sisinn/raspi_telexistence_vr/README.md

# raspi_telexistence_vr  

Display the remote image of Dual Fisheye camera on the VR goggles and experience the telexistence.

<https://github.com/sisinn/raspi_telexistence_vr>  

---
## Main Equipment  

* Raspberry Pi  
* Insta360 Air  
* BNO035  
* VR Goggles (P-VRG03BK)  
* LCD Monitor (LS055-CGS-LCD-SET)  

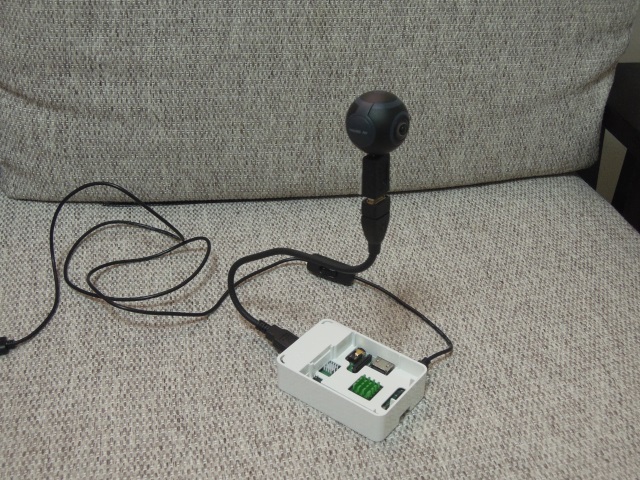
[picture p1: doc/img/sender.jpg]
sender
  
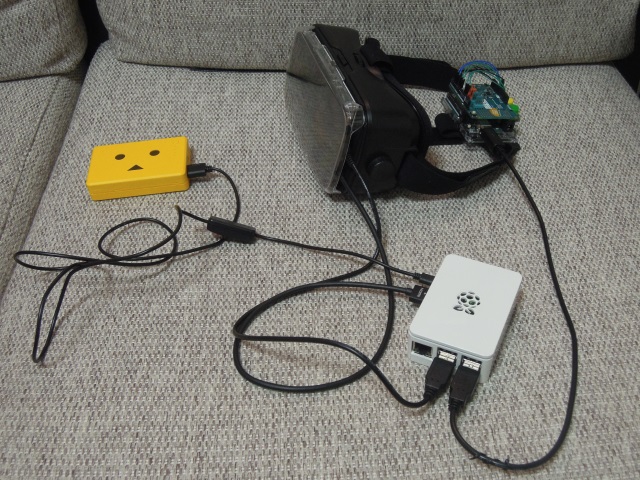
[picture p2: doc/img/receiver.jpg]
receiver
  

---
## Task  

The following sentences are in Japanese only.  
* [Commentary top](https://github.com/sisinn/raspi_telexistence_vr/blob/master/doc/top.md)
* [Raspberry Pi Init](https://github.com/sisinn/raspi_telexistence_vr/blob/master/doc/raspberry_init.md)
* [Sender](https://github.com/sisinn/raspi_telexistence_vr/blob/master/doc/sender.md)  
* [Receiver](https://github.com/sisinn/raspi_telexistence_vr/blob/master/doc/receiver.md)  
* [FFmpeg](https://github.com/sisinn/raspi_telexistence_vr/blob/master/doc/ffmpeg.md)  
* [H264](https://github.com/sisinn/raspi_telexistence_vr/blob/master/doc/h264.md)  
* [openFrameworks](https://github.com/sisinn/raspi_telexistence_vr/blob/master/doc/openframeworks.md)  
* [OpenGL](https://github.com/sisinn/raspi_telexistence_vr/blob/master/doc/vr360.md)  
* [3DoF](https://github.com/sisinn/raspi_telexistence_vr/blob/master/doc/3dof.md)  
* [VR Goggles](https://github.com/sisinn/raspi_telexistence_vr/blob/master/doc/goggles.md)  
* [Complete](https://github.com/sisinn/raspi_telexistence_vr/blob/master/doc/complete.md)  
* [Calibration](https://github.com/sisinn/raspi_telexistence_vr/blob/master/doc/calibration.md)  

---
## Demo  

Virtual Watermelon splitting in side view  
Virtual Watermelon splitting in side view (http://www.youtube.com/watch?v=ms5B0luU0no)  

---
## Author

[sisinn](https://github.com/sisnn)
