sisinn/raspi_telexistence_vr/doc/h264.md

# 全天球カメラとVRゴーグルで、テレイグジスタンス体験(6)

[前ページ](./ffmpeg.md) / [top](./top.md) / [次ページ](./openframeworks.md)  

## 6. H.264対応

MotionJPEGでの配信は、ネットワーク負荷が高いので、H.264で配信ができるように環境を構築する。  

### ■カメラデータの保存
---
FFmpegを使って、UVCのH264データを加工せずに、mp4形式で保存  
```
ffmpeg -f v4l2 -input_format h264 -video_size 1920x960 -framerate 30 -i /dev/video0 -vcodec copy -an test.mp4
```

※時刻情報が認識できないみたい  
```
[mp4 @ 0x2eefda0] Timestamps are unset in a packet for stream 0. This is deprecated and will stop working in the future. Fix your code to set the timestamps properly
[mp4 @ 0x2eefda0] Non-monotonous DTS in output stream 0:0; previous: 0, current: 0; changing to 1. This may result in incorrect timestamps in the output file.
```  

再生確認  
```  
omxplayer --win '0 0 1920 1080' test.mp4
```  

※ちなみに、解像度＝2560x1280では、エンコードはできるが、再生は表示が化けて正しく再生できない。  
もともとハード支援機能の性能的には無理だと思われるので、ここでは深追いしない。  

### ■カメラデータの配信  
---
FFmpegを使って、UVCのH264データを加工せずに、MPEG-TS形式で配信  

送信側  
```
ffmpeg -f v4l2 -input_format h264 -video_size 1920x960 -framerate 30 -i /dev/video0 \
 -vcodec copy -an \
 -f mpegts udp://192.168.11.66:1234
```
※上記では、有線LANで受信側IPアドレスを指定  

受信側  
```  
omxplayer --win '0 0 1920 1080' udp://192.168.11.66:1234
```  

※送信側、受信側どちらを先に起動しても、接続OK  
※UDPで送るため、パケット欠落の可能性がある。その際は、映像が乱れる。  

目視レベルで遅延量が2秒ぐらいある。MotionJPEG時と同等であるが、もう少し改善したい。  

#### 解像度＝1920x960の場合  

＜CPU性能:受信側＞  
```  
Linux 4.14.52-v7+ (raspberrypi)         08/03/18        _armv7l_        (4 CPU)

23:38:50     CPU    %usr   %nice    %sys %iowait    %irq   %soft  %steal  %guest  %gnice   %idle
23:38:50     all    2.66    0.00    3.31    0.63    0.00    0.10    0.00    0.00    0.00   93.30
23:38:50       0    2.30    0.00    3.71    0.54    0.00    0.41    0.00    0.00    0.00   93.04
23:38:50       1    3.42    0.00    3.04    0.43    0.00    0.00    0.00    0.00    0.00   93.11
23:38:50       2    2.40    0.00    3.00    0.64    0.00    0.00    0.00    0.00    0.00   93.95
23:38:50       3    2.50    0.00    3.49    0.89    0.00    0.00    0.00    0.00    0.00   93.12
```  

＜ネットワークトラフィック:受信側＞  
```  
   # Host name (port/service if enabled)            last 2s   last 10s   last 40s cumulative
--------------------------------------------------------------------------------------------
   1 192.168.11.66                            =>         0b         0b         0b         0B
     raspberrypi                              <=     8.45Mb     7.41Mb     7.41Mb     7.41MB
   2 192.168.11.66                            =>     12.6Kb     6.95Kb     6.95Kb     6.95KB
     DESKTOP-SISINN                           <=       960b       440b       440b       440B
   3 192.168.11.66                            =>         0b       288b       288b       288B
     router.asus.com                          <=         0b       425b       425b       425B
--------------------------------------------------------------------------------------------
Total send rate:                                     12.6Kb     7.23Kb     7.23Kb
Total receive rate:                                  8.46Mb     7.41Mb     7.41Mb
Total send and receive rate:                         8.47Mb     7.42Mb     7.42Mb
--------------------------------------------------------------------------------------------
Peak rate (sent/received/total):                     12.6Kb     8.50Mb     8.51Mb
Cumulative (sent/received/total):                    7.23KB     7.41MB     7.42MB
============================================================================================
```  

[前ページ](./ffmpeg.md) / [top](./top.md) / [次ページ](./openframeworks.md)
