sisinn/raspi_telexistence_vr/doc/vr360.pdf

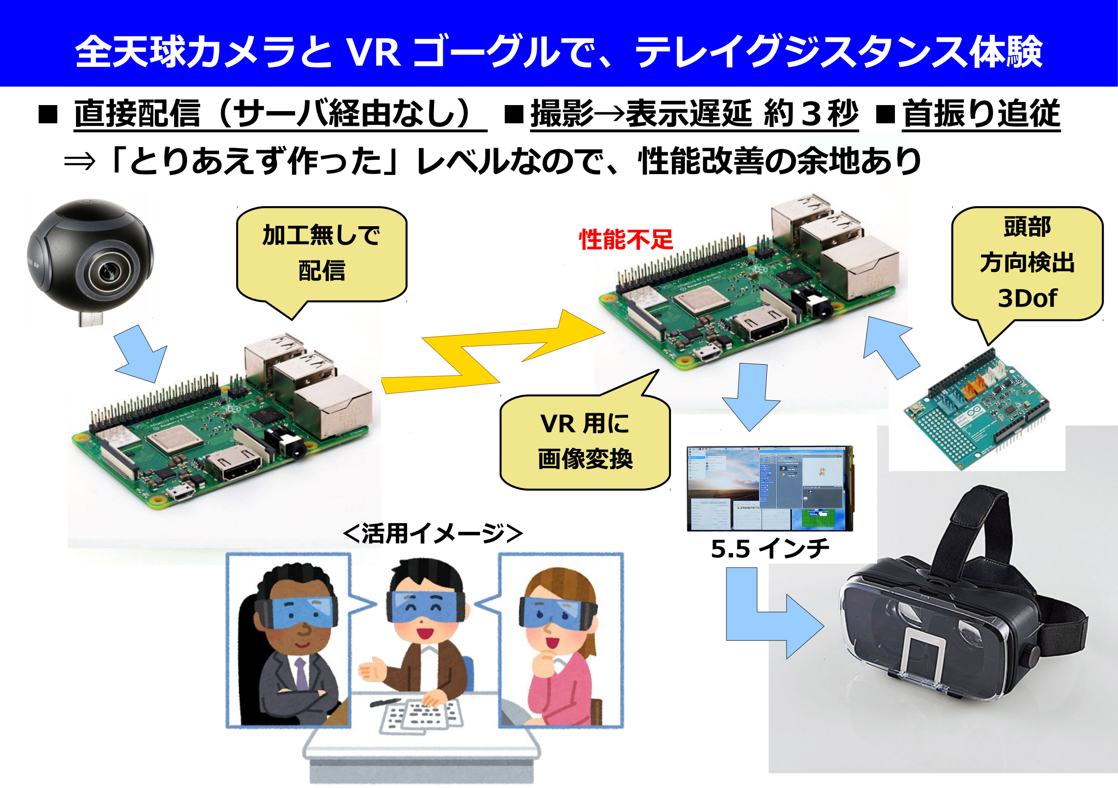
[picture p14: page 1]

全天球カメラと VR ゴーグルで、テレイグジスタンス体験
■ 直接配信（サーバ経由なし） ■撮影→表示遅延 約３秒 ■首振り追従 ⇒「とりあえず作った」レベルなので、性能改善の余地あり

加工無しで
配信

頭部
方向検出
3Dof

VR 用に
画像変換

### 5.5 インチ

性能不足

＜活用イメージ＞
