sisinn/raspi_telexistence_vr/doc/img/goggles.jpg

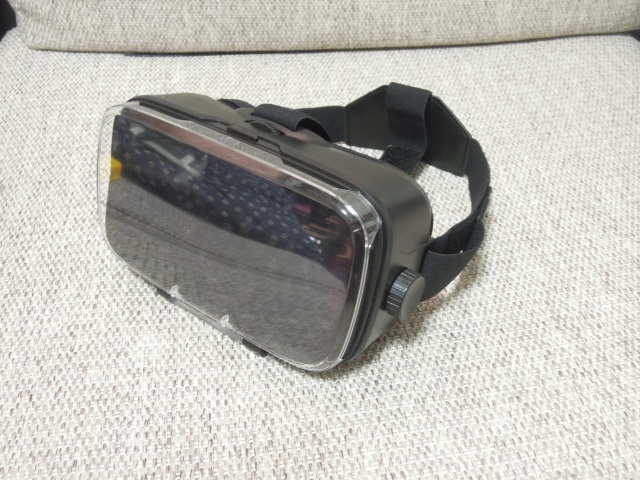
doc/img/goggles.jpg
