sisinn/raspi_telexistence_vr/doc/img/raspberry-monitor.jpg

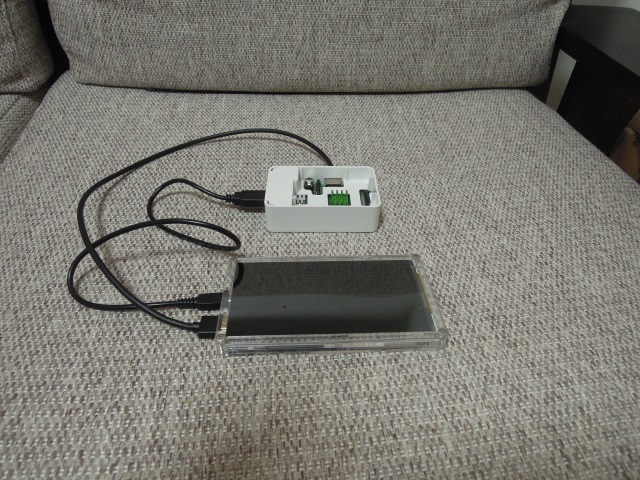
doc/img/raspberry-monitor.jpg
