sisinn/raspi_telexistence_vr/doc/calibration.md

# 全天球カメラとVRゴーグルで、テレイグジスタンス体験(12)

[前ページ](./complete.md) / [top](./top.md)  

## 11. 微調整  

Insta360 Airの前後映像は、傾いているとのことで、  
バーテックスシェーダの処理で、前後それぞれの円に対して、回転できるようにしておく  

受信側処理のvr360_viewに対し、各引数を変更しながら、  
目測で効果を確認  

結果、個体差があるかもしれないが、うちのInsta360 Airでいい感じになったのは、以下の値  
* 視野角は、115°  
* 前方の傾きは、-3°  

```
vr360_view  -q w,_y,_x,_z -t 90 -f 1.0 -r 115 -s 0.02 -a -3 -b 0
```

[前ページ](./complete.md) / [top](./top.md)
