sisinn/raspi_telexistence_vr/src/raspberry_pi/receiver/boot/config.txt

#==================================================================================#
# HDMI output setting for SHARP LS055T1SX01A
#==================================================================================#
# HDMI Basic configuration
#==================================================================================#
hdmi_pixel_freq_limit=400000000
hdmi_drive=2
disable_overscan=1
dtparam=audio=on
start_x=1
hdmi_group=2
hdmi_mode=87
hdmi_force_hotplug=1
gpu_mem=512
dtparam=spi=on
dtparam=i2c_arm=on
#==================================================================================#
# 1080 x 1920 5.5Inch
#==================================================================================#
# Main Setting
#----------------------------------------------------------------------------------#
hdmi_timings=1080 0 60 10 35 1920 0 4 4 2 0 0 0 50 0 114352500 0
max_framebuffer_width=1920
max_framebuffer_height=1920
#----------------------------------------------------------------------------------#
# Portrait or Landscape Setting
#Portrait-1 (FPC is bottom side.)
#----------------------------------------------------------------------------------#
#display_rotate=0
#framebuffer_width=1080
#framebuffer_height=1920
#----------------------------------------------------------------------------------#
# Landscape-1 (FPC is right side.)
#display_rotate=1
#----------------------------------------------------------------------------------#
display_rotate=1
framebuffer_width=1920
framebuffer_height=1080
#----------------------------------------------------------------------------------#
# Portrait-2 (FPC cable is upper side.)
#display_rotate=2
#----------------------------------------------------------------------------------#
#display_rotate=2
#framebuffer_width=1080
#framebuffer_height=1920
#----------------------------------------------------------------------------------#
# Landscape-2 (FPC is left side.)
#display_rotate=3
#----------------------------------------------------------------------------------#
#display_rotate=3
#framebuffer_width=1920
#framebuffer_height=1080
#----------------------------------------------------------------------------------#

# For more options and information see
# http://rpf.io/configtxt
# Some settings may impact device functionality. See link above for details

# uncomment if you get no picture on HDMI for a default "safe" mode
#hdmi_safe=1

# uncomment this if your display has a black border of unused pixels visible
# and your display can output without overscan
#disable_overscan=1

# uncomment the following to adjust overscan. Use positive numbers if console
# goes off screen, and negative if there is too much border
#overscan_left=16
#overscan_right=16
#overscan_top=16
#overscan_bottom=16

# uncomment to force a console size. By default it will be display's size minus
# overscan.
#framebuffer_width=1280
#framebuffer_height=720

# uncomment if hdmi display is not detected and composite is being output
#hdmi_force_hotplug=1

# uncomment to force a specific HDMI mode (this will force VGA)
#hdmi_group=1
#hdmi_mode=1

# uncomment to force a HDMI mode rather than DVI. This can make audio work in
# DMT (computer monitor) modes
#hdmi_drive=2

# uncomment to increase signal to HDMI, if you have interference, blanking, or
# no display
#config_hdmi_boost=4

# uncomment for composite PAL
#sdtv_mode=2

#uncomment to overclock the arm. 700 MHz is the default.
#arm_freq=800

# Uncomment some or all of these to enable the optional hardware interfaces
#dtparam=i2c_arm=on
#dtparam=i2s=on
#dtparam=spi=on

# Uncomment this to enable the lirc-rpi module
#dtoverlay=lirc-rpi

# Additional overlays and parameters are documented /boot/overlays/README

# Enable audio (loads snd_bcm2835)
dtparam=audio=on
