sisinn/raspi_telexistence_vr/(commit log)

2018-08-08 Initial registration
    [config.txt]
2018-08-08 写真追加 コードのURL追記
2018-08-10 Youtubeリンクを追加
2018-08-10 READMEにも機材写真を追加
2018-08-10 写真アドレス間違いを修正
2018-08-10 ケーブル断線を追記
2018-08-10 3DoF、テレイグジスタンスに関する解説を追加
2018-08-10 表崩れを修正
2018-09-03 ・focal設定の実装ミス修正 ・前後円の傾き調整機能を追加 ・黄ボタンの機能として、3DoF無効モードを追加 ・メッシュの粒度を細かく ・微調整の説明を追記
    [main.cpp, ofApp.cpp, ofApp.h]
2019-01-09 プレゼン資料を追加
